AnjinMeili/ILDAWaveX16V2/hardware/ILDAWaveX16V2_REV_00.step

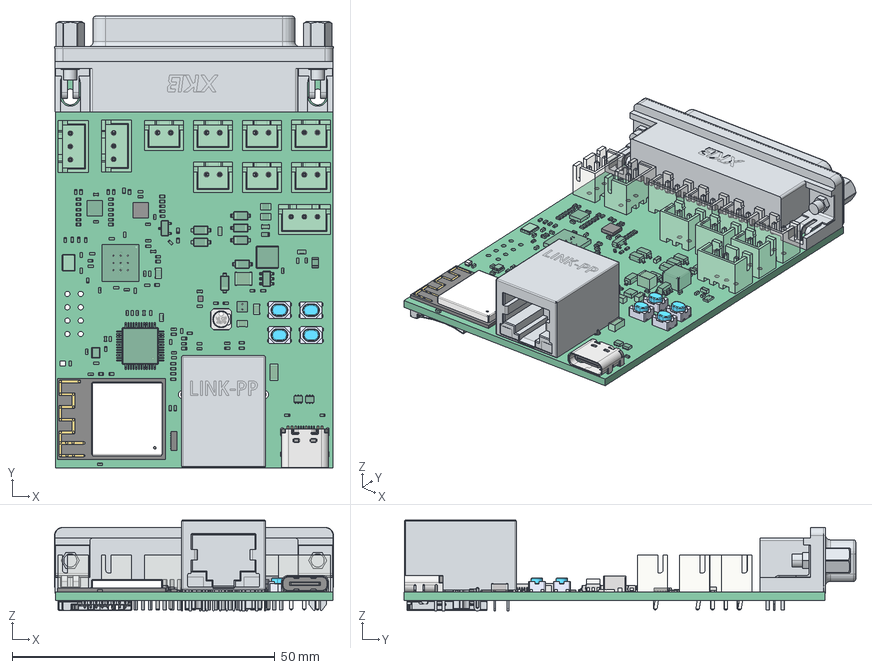
[picture p1: CAD file, 2026-05-17]
hardware/ILDAWaveX16V2_REV_00.step
53.0 x 85.9 x 17.3 mm
Pcb_a07e
C39_C_0402_1005Metric_de3879e7078b
C9_C_0402_1005Metric_89ffe173dfdc
R60_R_0402_1005Metric_7128ad95a7d4
R38_R_0402_1005Metric_595164d2e71e
R40_R_0402_1005Metric_1761894925cf
C35_C_0402_1005Metric_0a427dd6541f
R5_R_0402_1005Metric_44aaff508362
R20_R_0402_1005Metric_53d4fa7b819a
D3_D_SOD-123_a8e0f4504b51
F3_Fuse_0805_2012Metric_754eb351aef8
D6_D_SOD-123_a57883263e1a
U3_QFN-16-1EP_3x3mm_P0.5mm_EP1.7x1.7mm_20b41260c2ea
R8_R_0402_1005Metric_efa2c0d2ec63
J14_LPJ0013BHNL_64df485433be
User Library-VLCF4020
User Library-VLCF4021
User Library-VLCF4022
User Library-VLCF4023
J4_JST_B3B_XH_A_536eab15d6f0
C31_C_0402_1005Metric_9ddb804806a4
R28_R_0402_1005Metric_622625ac435b
R24_R_0402_1005Metric_195bccc64eb0
C27_C_0402_1005Metric_3719ef74f24a
J12_JST_B2B_XH_A_ac59ba0f6e81
R50_R_0402_1005Metric_2f21a58978ee
C36_C_0402_1005Metric_a0fd6fdf80a4
C33_C_0402_1005Metric_a57949c5f094
R59_R_0402_1005Metric_5a537d338885
R26_R_0402_1005Metric_998ac3366432
C30_C_0402_1005Metric_9c59da9d6e44
C51_C_0402_1005Metric_e0921f869e6f
C25_C_0402_1005Metric_3780bcc418de
R54_R_0402_1005Metric_c73f377d8052
R32_R_0402_1005Metric_e949ee6fe3ef
R10_R_0402_1005Metric_b8745a6824d8
J7_JST_B2B_XH_A_a2329b00c2bc
R39_R_0402_1005Metric_8e44019a6866
U5_WSON_8_1EP_2x2mm_P05mm_EP09x16mm_7ca23187abe5
XL-1010RGBC-WS2812B
XL-1010RGBC-WS2812B001
XL-1010RGBC-WS2812B002
XL-1010RGBC-WS2812B003
XL-1010RGBC-WS2812B004
XL-1010RGBC-WS2812B005
XL-1010RGBC-WS2812B006
XL-1010RGBC-WS2812B007
XL-1010RGBC-WS2812B008
XL-1010RGBC-WS2812B009
XL-1010RGBC-WS2812B010
NCP160AMX280TBG
NCP160AMX280TBG001
NCP160AMX280TBG002
NCP160AMX280TBG003
NCP160AMX280TBG004
NCP160AMX280TBG005
C12_C_1210_3225Metric_b1d4a9e3416f
C1_C_0402_1005Metric_c4c7f1a68555
R31_R_0402_1005Metric_2ccf47463f8c
C34_C_0402_1005Metric_a1cdbcd666e0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
