AnjinMeili/ILDAWaveX16V2/hardware/ILDAWaveX16_V2_REV_00_SCH.pdf

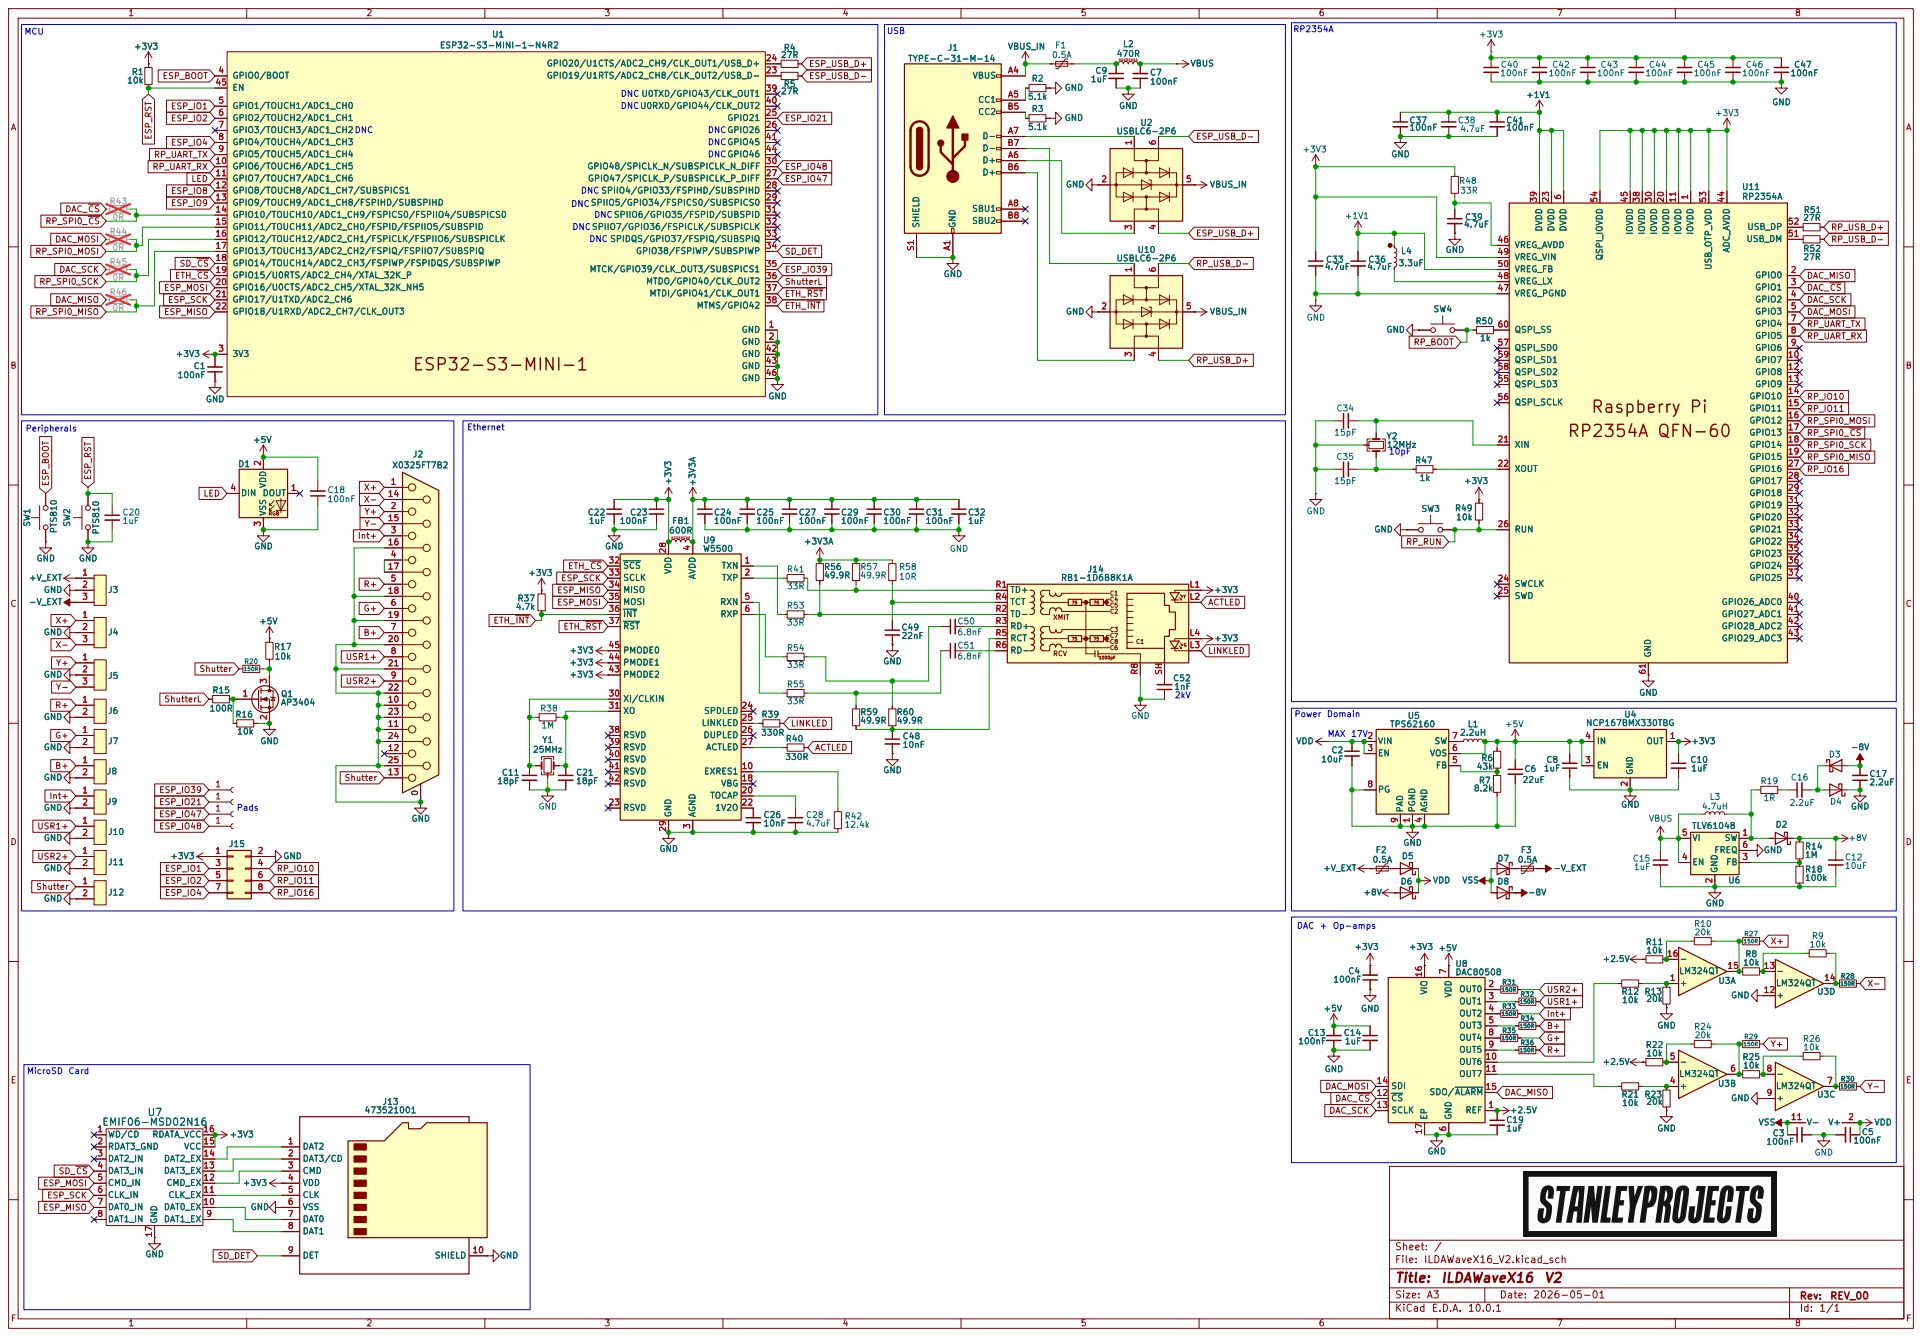
[picture p2: page 1]

MCU | J1 J1 VBUS_IN VBUS_IN 470R F1 L2 L2 | C38 4.7uF+3V3 GND | 100nF GND

100nF GND

27R +1V1 C41 100nF GND

Size: A3 | Rev: REV_00 | F Date: 2026-05-01
KiCad E.D.A. 10.0.1 | Id: 1/1
