AnjinMeili/ILDAWaveX16V2/firmware/RP2354/src/rp_settings.h

#pragma once

#include <stdbool.h>
#include <stdint.h>

typedef struct {
    uint32_t buffer_size_samples;
    uint32_t buffer_high_water_samples;
    uint32_t buffer_low_water_samples;
    bool mirror_x;
    bool mirror_y;
} rp_settings_t;

void rp_settings_load(void);
void rp_settings_get(rp_settings_t *settings);

bool rp_settings_save(uint32_t buffer_size_samples,
                      uint32_t buffer_high_water_samples,
                      uint32_t buffer_low_water_samples,
                      bool mirror_x,
                      bool mirror_y);
void rp_settings_save_and_reboot(uint32_t buffer_size_samples,
                                 uint32_t buffer_high_water_samples,
                                 uint32_t buffer_low_water_samples,
                                 bool mirror_x,
                                 bool mirror_y);
