AnjinMeili/ILDAWaveX16V2/(commit log)

2026-05-17 ESP32S3 V0.1.0 / RP2354 V0.1.0
2026-07-23 ESP32S3 V0.1.1 / RP2354 V0.1.0 - V1 SD Card fix - detection using refresh button
2026-10-23 RP2354: track output mode, add scope trace pins and USB log
    - Track output mode (HARD_ZERO, START_BLANK, STREAMING, UNDERRUN_BLANK,
    FAILSAFE_BLANK), counting only real transitions, plus failsafe events
    - Drive GPIO10 (RP_IO10) while started and GPIO11 (RP_IO11) while blanked
    - Log boot, commands and per-second output status to USB serial when a
    console is attached; skip all logging work otherwise
    - Read the DMA word counter lock-free so logging never waits on core1
    - Move DAC and UART pin numbers into project_config.h, matching the
    pins the drivers already used
2026-10-23 ESP32S3: blank laser in IDN gap padding, keep SD hotplug state at boot
    - Pad short IDN packets by holding X/Y with color channels blanked,
    instead of repeating the last lit sample
    - Seed the hotplug task with the mounted state so a card inserted at
    boot is not re-detected as a new insertion
2026-10-23 ESP32S3: ILDA preview, live XY scale, streamed SD listing
    - Add /api/ilda/preview: file summary, decimated frame points, and an
    animated all-frames mode, served from a worker task so stop and status
    requests are never queued behind a large preview
    - Add XY scale (10-100%) to /api/ilda/start and /api/ilda/scale; the
    player picks up changes at packet boundaries
    - Stream /api/sd/list in chunks so folders are listed in full
    - Web UI: Preview button, animated canvas, scale slider, Project/Stop
    - Share ILDA header and palette helpers between player and preview
    - Allocate the player buffer from the preflight count, and report a file
    that grows during load instead of a misleading out-of-memo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
2026-10-23 ESP32S3: enable PSRAM in sdkconfig defaults
    A fresh build had CONFIG_SPIRAM off. The Ether Dream ring allocation then
    failed with ESP_ERR_NO_MEM, and ESP_ERROR_CHECK in app_main caused a boot
    loop. The V2 module has 2 MB PSRAM.
2026-10-23 ESP32S3: load the preview for the file being played
    Play no longer refreshed the preview after the preview fetch was removed
    from the projection path. Previews now run on their own task, so loading
    one cannot delay Stop; restore the preview and highlight the playing row.
2026-10-23 ESP32S3: accept data-less closing ILDA headers, check before stopping
    Ten sample files ended with a closing header that repeats the frame's
    point count instead of zero. Both parsers read it as a frame with no
    data and rejected the file, and Play had already stopped the running
    output, leaving the DAC idle.
    - Treat a header with no bytes after it as end of file; a frame with
    partial point data is still rejected as truncated
    - Validate the file before stopping current output or freeing samples
    - Log the reason and byte offset for every rejected file
    - When Play fails on another file, open its preview to show why
2026-10-23 ESP32S3: square preview field, keep short lit segments
    - Draw the preview in a square field with one scale for X and Y; ILDA
    coordinates are square, so the 8:5 canvas stretched shapes
    - Draw a lit point from the previous point even when that point is
    blanked, the usual ILDA convention; segments that start after a
    blanked jump were missing
    - When decimating large frames, keep both ends of every blank/lit change
    so short segments survive (Ferrite Core lost its inner cracks)
2026-10-23 ESP32S3: play a folder of ILDA files
    - Add /api/ilda/play_folder: the ESP32 scans the folder (optionally its
    subfolders), sorts the .ild files by name, and plays them in order,
    repeating until stopped
    - Operator settings: hold time for single-frame files (default 5 s),
    plays per animation (default 1), include subfolders; the web UI
    remembers them per browser
    - Check files before stopping current output; drop files that fail
    during playback; move blanked from one file's last point to the next
    file's first
    - Report ilda_file and ilda_folder in /api/rp/status; the preview
    follows the playing file
    - Fold the three packet-send blocks in the sender into one helper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
2026-10-23 ESP32S3: IDN and Ether Dream send only full packets, prebuffer start
    Both feeds sent a packet every pass, padding whatever the ring held, even
    nothing, up to 256 points. Network points arrive in bursts, so the RP
    played filler between bursts: playback ran slower than the sender, the
    RP buffer filled (about 0.5 s of lag), the ring overflowed and the image
    jumped. The first seconds stuttered before the backlog formed.
    - Send only full packets while the stream flows; flush a padded partial
    packet only after 100 ms without new points
    - Queue about 100 ms of points on the RP before START
    - Pad Ether Dream's flushed tail with blanked points, not the last lit one
    This matches the ILW feed, whic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
2026-10-23 ESP32S3: handle Ether Dream 'u' (update point rate)
    Clients such as Modulaser send 'u' to change the point rate during
    playback. It has the same 7-byte layout as 'b'. The firmware treated it
    as unknown and did not read its 6 payload bytes, so they were parsed as
    commands: the zero bytes became emergency stops, output stopped, and
    the client had to reconnect.
    Read the full command, apply the new rate to the RP, and ACK. Tested
    with Modulaser switching 30k -> 20k pps mid-stream: no dropout.
2026-10-23 ESP32S3: widen TCP window within W5500 buffer, deepen lwIP mailboxes
    The default 5760-byte TCP window capped Ether Dream ingest near 24 kpps.
    A 32 KB window let the sender burst past the W5500's 16 KB MACRAW RX
    buffer, dropping frames and stalling TCP on retransmits, so clients
    timed out and reconnected. 11520 bytes (8 x MSS) fits the buffer and
    doubles the old window.
    TCP and UDP receive mailboxes grow from 6 to 32 so bursts of IDN and
    ILW packets are queued instead of dropped. IDN now holds a full RP
    buffer with no underruns at 30 kpps.
2026-10-23 RP2354: output at the configured rate
    The DAC clock divider assumed 72 PIO cycles per 24-bit word, but
    dac80508_tx.pio takes 75 (pull, set, 24 x 3, trailing nop), so output
    ran 4% slow. Batch writes also blocked until their DMA finished and
    then built the next batch while the PIO idled, losing about 1% more.
    Use the real cycle count, and double-buffer the batch words so the
    next batch is built while the previous one is still being sent. A
    22 kpps stream now outputs about 22,000 samples/s instead of 21,100.
2026-10-23 ESP32S3: Ether Dream reports its real queue and keeps a short RP cushion
    buffer_fullness only counted the ESP ring, which the feed task emptied
    into the RP's 16k buffer as fast as it would take points. Clients saw
    a level jumping between about 100 and 3,500 points that had nothing to
    do with the real queue, and Modulaser paced so badly that a 22 kpps
    stream got about 17,700 points/s through.
    The feed task now keeps about 3,072 samples queued on the RP and leaves
    the rest in the ring. Fullness reports the ring plus that estimate,
    capped below capacity. A separate task re-reads the RP's fill over UART
    every 100 ms so the feed task never blocks on a status round trip.
    With the RP rate fix, 22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
2026-10-23 README, tools: document network streaming behavior, add test tools
    README: replace "needs optimization at higher point rates" for IDN and
    Ether Dream with how each one is paced, the latency knob for IDN, the
    client buffer setting for Ether Dream, and the rates tested with
    Modulaser.
    tools/serial_logger.py logs either chip's USB serial port with
    timestamps and reconnects across cable swaps, without resetting the
    ESP32-S3. tools/stream_stats.py prints points/s per protocol,
    underruns/s and RP fill from /api/rp/status.
2026-10-23 Add AGENTS.md with build, flash and hardware-safety notes
    Covers the shared USB-C port, flashing both chips from the command
    line, checking output is stopped first, and constraints found while
    tuning network streaming (W5500 RX buffer, RP BUFFER writes flash,
    blocking UART status reads, DAC PIO cycle count).
2026-10-23 ESP32S3: advertise the Ether Dream capacity the ring can hold
    The ring keeps one slot empty, so it holds 8,191 points, but discovery
    and ping replies advertised 8,192. A client that filled to the
    advertised capacity while the RP cushion estimate was zero got a
    FULL reply and lost that batch. Advertise 8,191 and cap the reported
    fullness at the same value.
    Verified: the discovery broadcast now reports buffer_capacity=8191.
2026-10-23 ESP32S3: reject ILDA start paths that don't fit instead of playing test.ild
    /api/ilda/start read the query into 256 bytes and the path into 192.
    A longer request, easy to reach with nested SD folders, made either
    read fail, and the handler then fell back to /sdcard/test.ild and
    played that instead of the selected file.
    Size both buffers for an encoded SD path and return 400 when either
    read is truncated. The decoded path must be inside /sdcard/ and pass
    the same check the SD browser uses. A request with no path still
    plays test.ild, as before.
    Verified on the board, with output stopped throughout:
    - /sdcard/../x.ild, /other/x.ild, /sdcard/, /sdcard/a//b.ild: 400
    - a 264-byte encoded path (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
2026-10-23 ESP32S3: start a prebuffered stream that idles on a packet boundary
    Ether Dream and IDN start the RP once 3,072 samples are queued, or
    when a short tail is flushed. A burst that ends exactly on a 256-point
    packet boundary below 3,072 points sends only full packets and leaves
    no tail, so neither condition fired and the burst never played while
    the connection stayed open.
    When the stream has been idle for 100 ms with nothing left to flush,
    start whatever is already queued. Ether Dream's start code moves into
    feed_output_start() so both start paths seed the RP queue estimate.
    Verified on the board with a 1,024-point burst at 30 kpps, connection
    held open:
    - Ether Dream: output started 107 ms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
2026-10-23 ESP32S3: discard a stream's prebuffer when it is cancelled before START
    Ether Dream and IDN now queue up to 3,072 samples on the RP before
    START. If the client stopped, disconnected or closed the IDN session in
    that window, the feed task called rp_manager_output_stop(), which does
    nothing when the feed holds no output reference. The queued samples
    stayed on the RP, and the next START from any producer played them
    first. The same call could also release another producer's reference.
    On exit, a feed now releases output only if it started it. Otherwise
    rp_manager_output_discard_unstarted() resets the ESP payload queue,
    waits for any packet already on the wire, and sends CLEAR, unless
    another p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
2026-10-23 ESP32S3: keep the test pattern running when Play is rejected
    The Play and folder-play handlers stopped the test pattern before the
    player looked at the request. A missing file, an empty folder or a
    folder of rejected files then returned an error with the test pattern
    already stopped.
    Stop the test pattern in begin_playback(), after the file has passed
    its checks and before the current output is touched. If it does not
    stop, the start fails and the current output is left as it was.
    Verified on the board, test pattern running:
    - play folder "Empty": ESP_ERR_NOT_FOUND, test pattern still running
    - play folder "Bad Touch" (3 files over the sample limit):
    ESP_ERR_NOT_FOUND, test pattern still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
2026-10-23 ESP32S3: keep evenly spaced preview points across the whole frame
    Decimated previews split their 256 points between evenly spaced samples
    and the ends of each blank/lit change, but transitions took slots with
    nothing held back for the evenly spaced points still to come. A frame
    with many changes filled the array early and lost the rest of the
    frame, including its last point.
    Admit a transition only while the slots still owed to the remaining
    evenly spaced points stay free. Points are captured in file order, so
    the preview stays in order.
    Checked with a simulation of the decimation loop (12 cases: alternating,
    3-point and sparse blanking; frames of 257 to 40,000 points):
    - before: 9 of 12 l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
2026-10-23 ESP32S3: pausing the preview no longer drops a pending load
    Pausing bumped previewRequestId, so a preview still loading had its
    response discarded as stale: the card stayed on "Loading" with no
    frames, and Play could not recover. Pause now only stops the animation
    timer; loadIldaPreview() already changes the request ID when it starts
    a new load.
    Verified on the board: pausing during a preview load finishes the load
    and shows the frame, paused.
    Reported by Copilot review on PR #4.
2026-10-24 fix(rp2354): 🐛 Set the physical flash size to 2 MiB
2026-10-24 ESP32S3: restore the V1 build (rp_manager_output_discard_unstarted)
    What: the BOARD_VERSION=1 build stopped linking after PR #4. Ether Dream
    and IDN now call rp_manager_output_discard_unstarted() when a stream is
    cancelled before START, and only the V2 rp_manager.c defined it.
    Why: V1 is still a supported build target (README: experimental). There
    is no CI, so the break went unnoticed.
    How: rp_manager_v1.c gets the same rule as V2: when no producer holds the
    output, clear the V1 ring, under the push mutex so no producer writes
    while it resets; otherwise do nothing, since another producer's samples
    share the ring.
    Verified by building only (no V1 board available here):
    - Before: upstream m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
